anaescobarj/aco-swarm/out/convergence.png

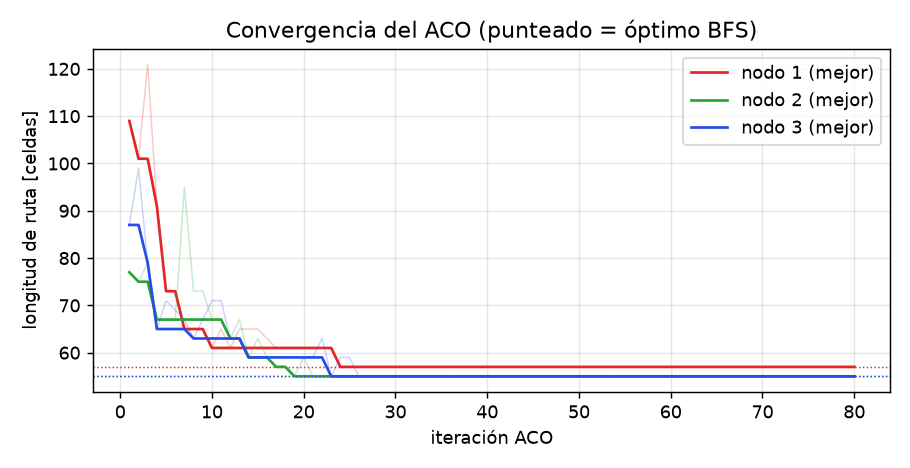
out/convergence.png
