anaescobarj/aco-swarm/robot-esp32/docs/img/app_control.png

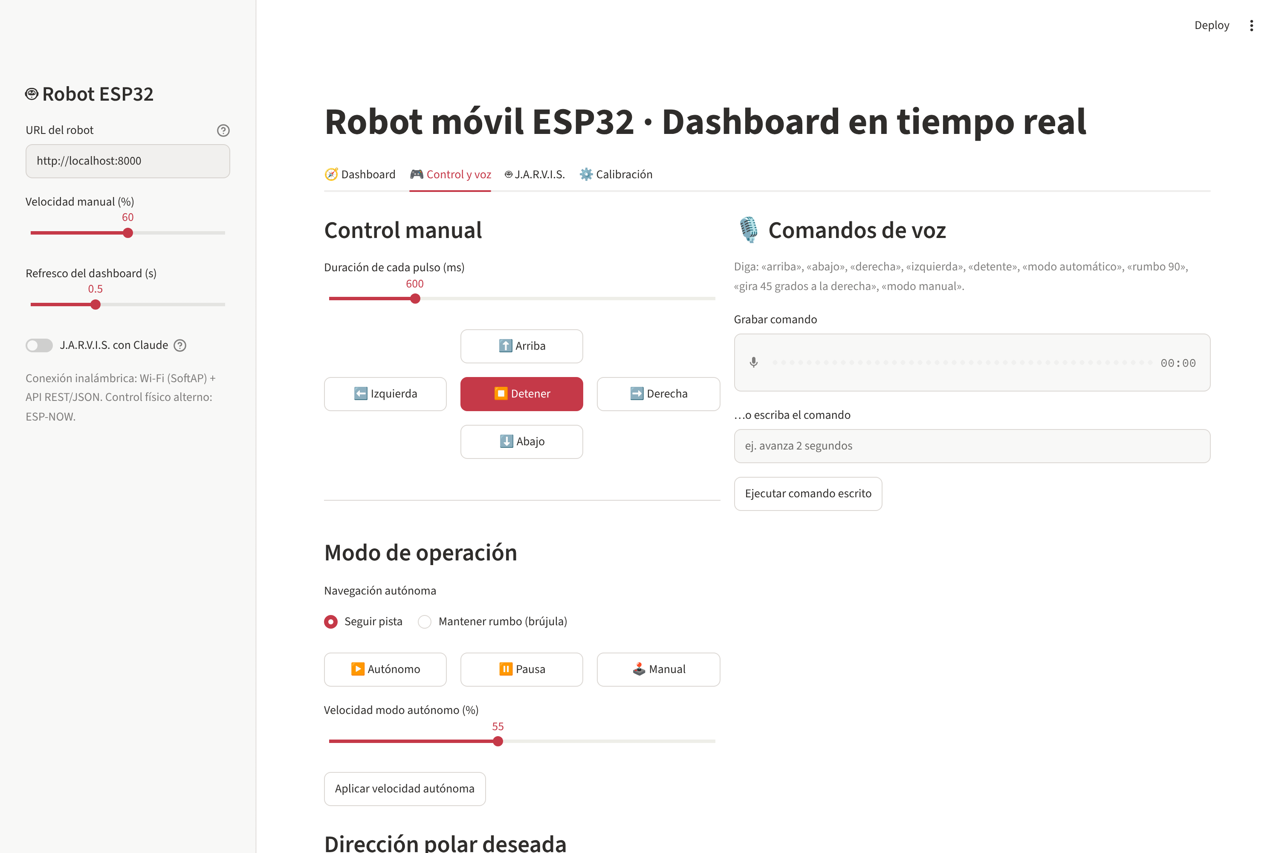
robot-esp32/docs/img/app_control.png
