anaescobarj/aco-swarm/robot-esp32/docs/img/bloque_app.png

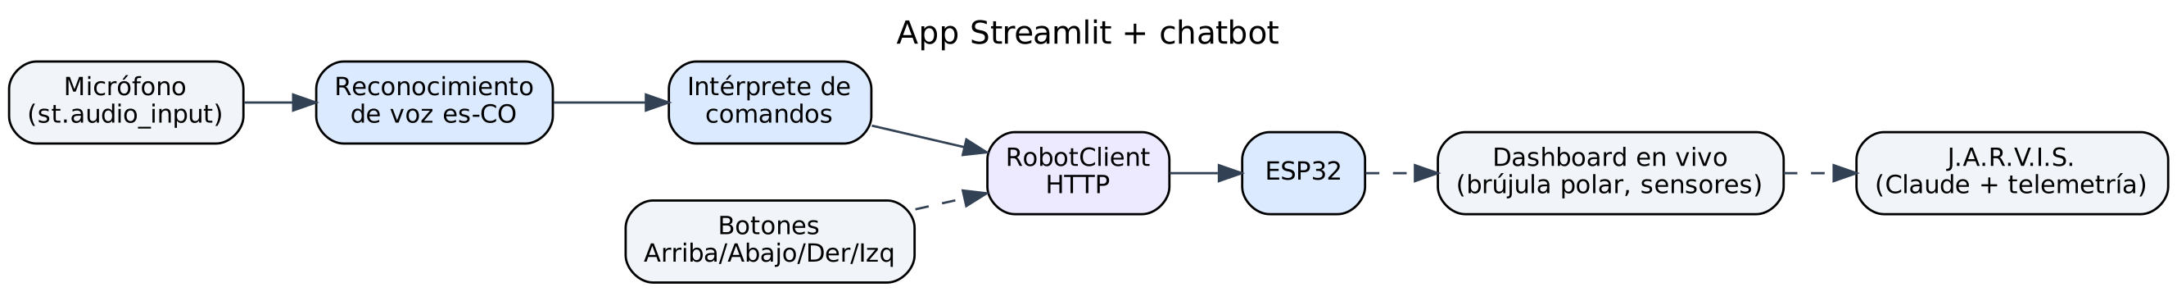
robot-esp32/docs/img/bloque_app.png
