anaescobarj/aco-swarm/robot-esp32/docs/img/bloque_brujula.png

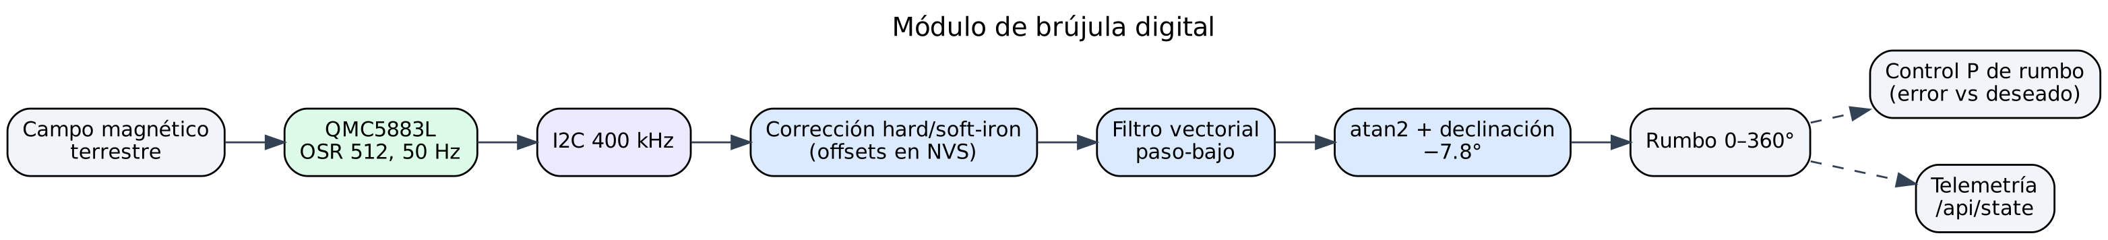
robot-esp32/docs/img/bloque_brujula.png
