anaescobarj/aco-swarm/robot-esp32/docs/img/bloque_color.png

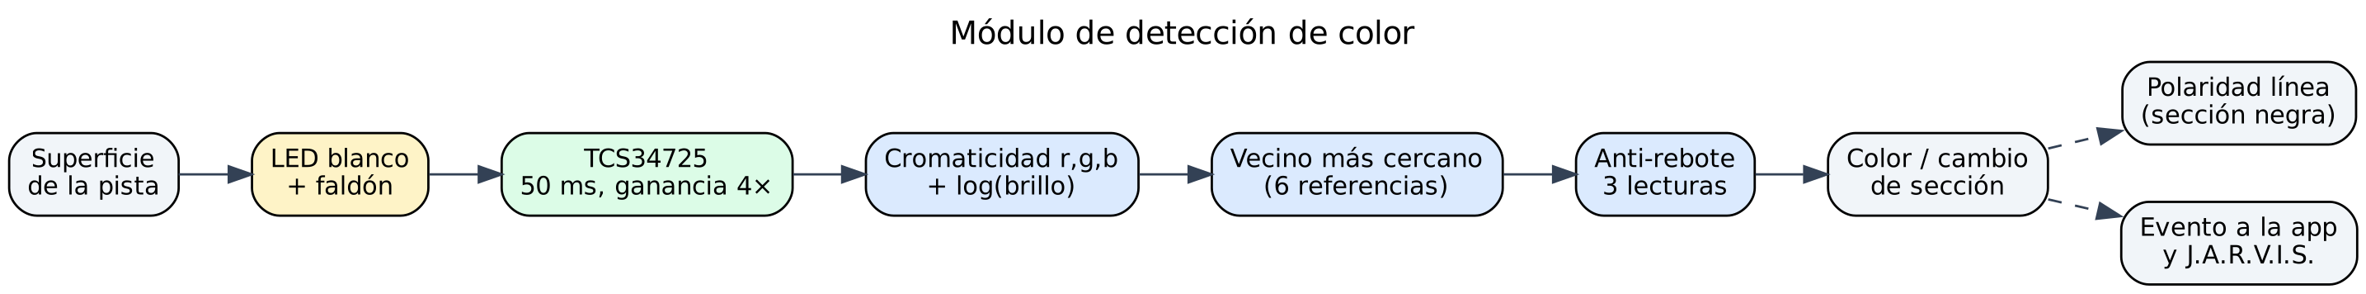
robot-esp32/docs/img/bloque_color.png
