anaescobarj/aco-swarm/robot-esp32/docs/img/bloque_comunicaciones.png

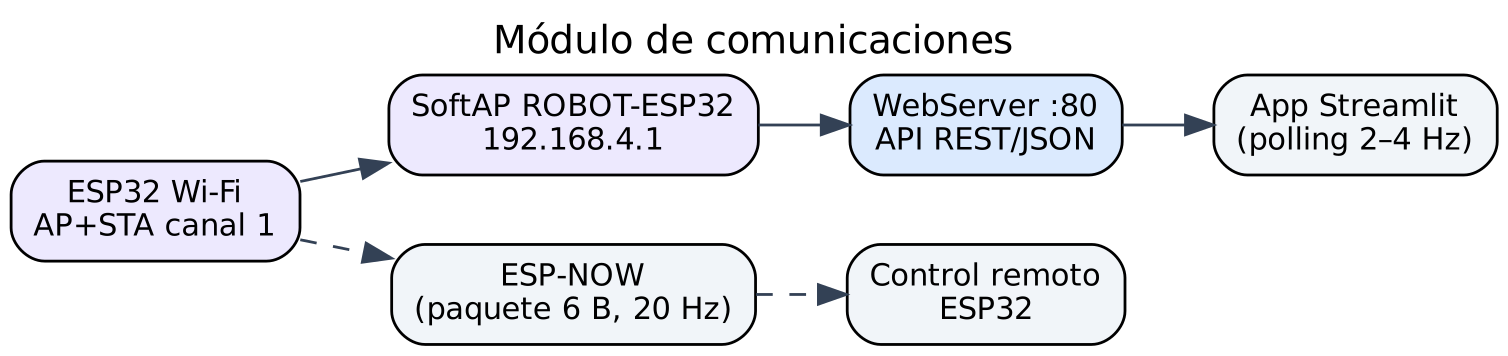
robot-esp32/docs/img/bloque_comunicaciones.png
