anaescobarj/aco-swarm/robot-esp32/docs/img/bloque_locomocion.png

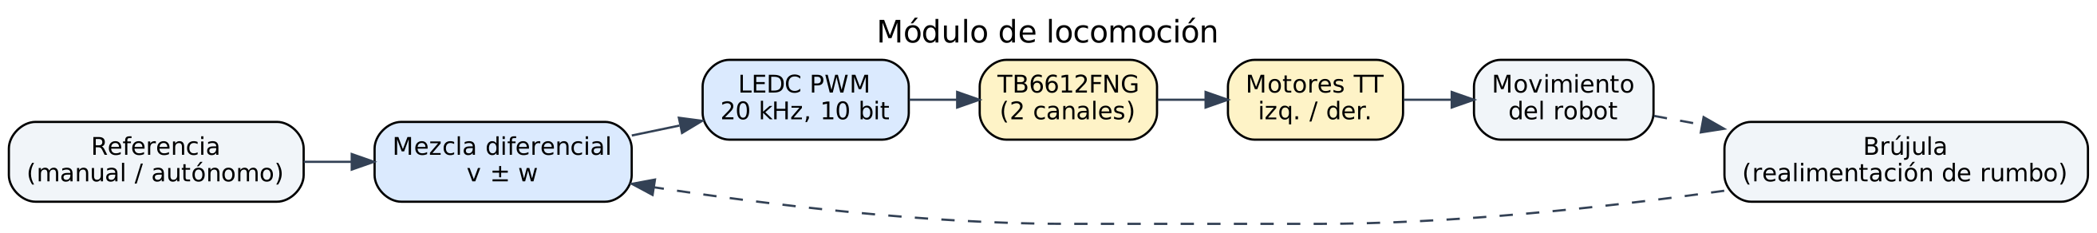
robot-esp32/docs/img/bloque_locomocion.png
