anaescobarj/aco-swarm/robot-esp32/docs/img/esquematico.png

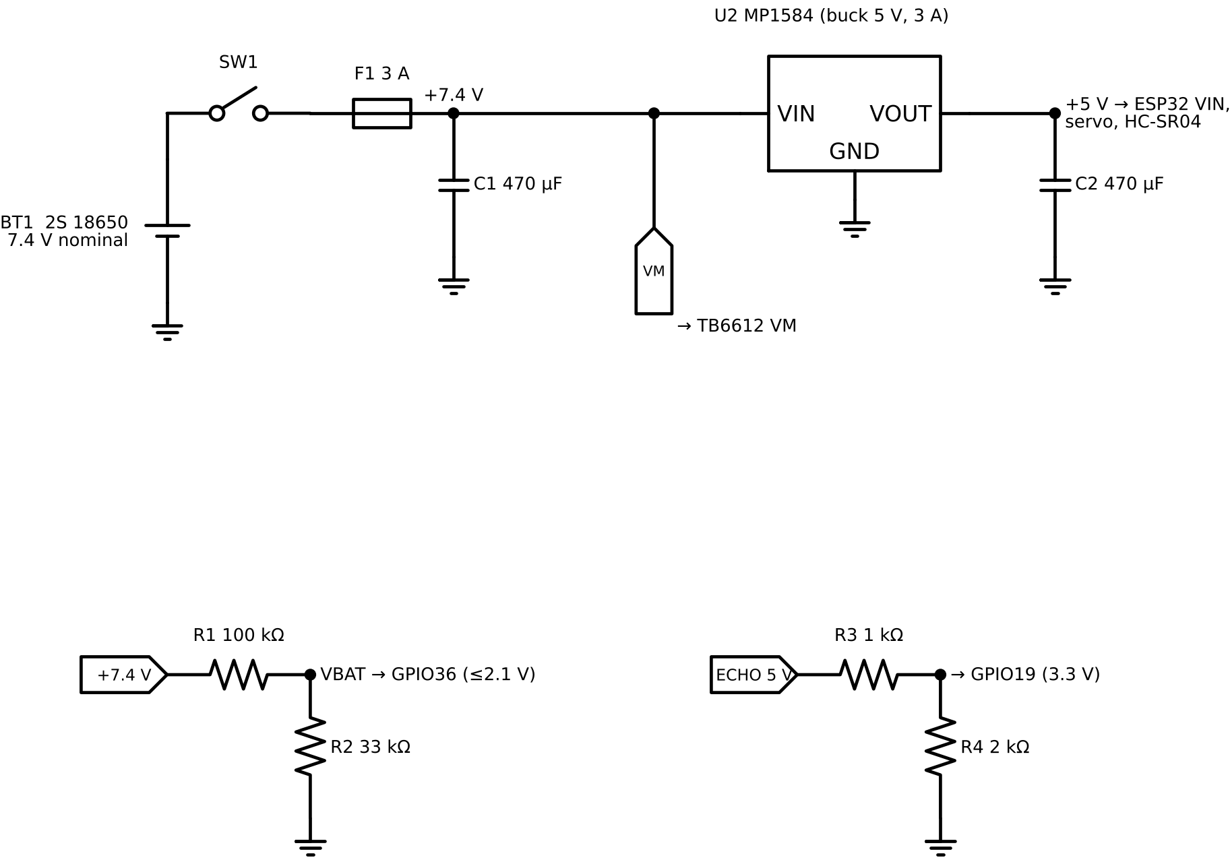
robot-esp32/docs/img/esquematico.png
