anaescobarj/aco-swarm/robot-esp32/docs/img/esquematico_esp32.png

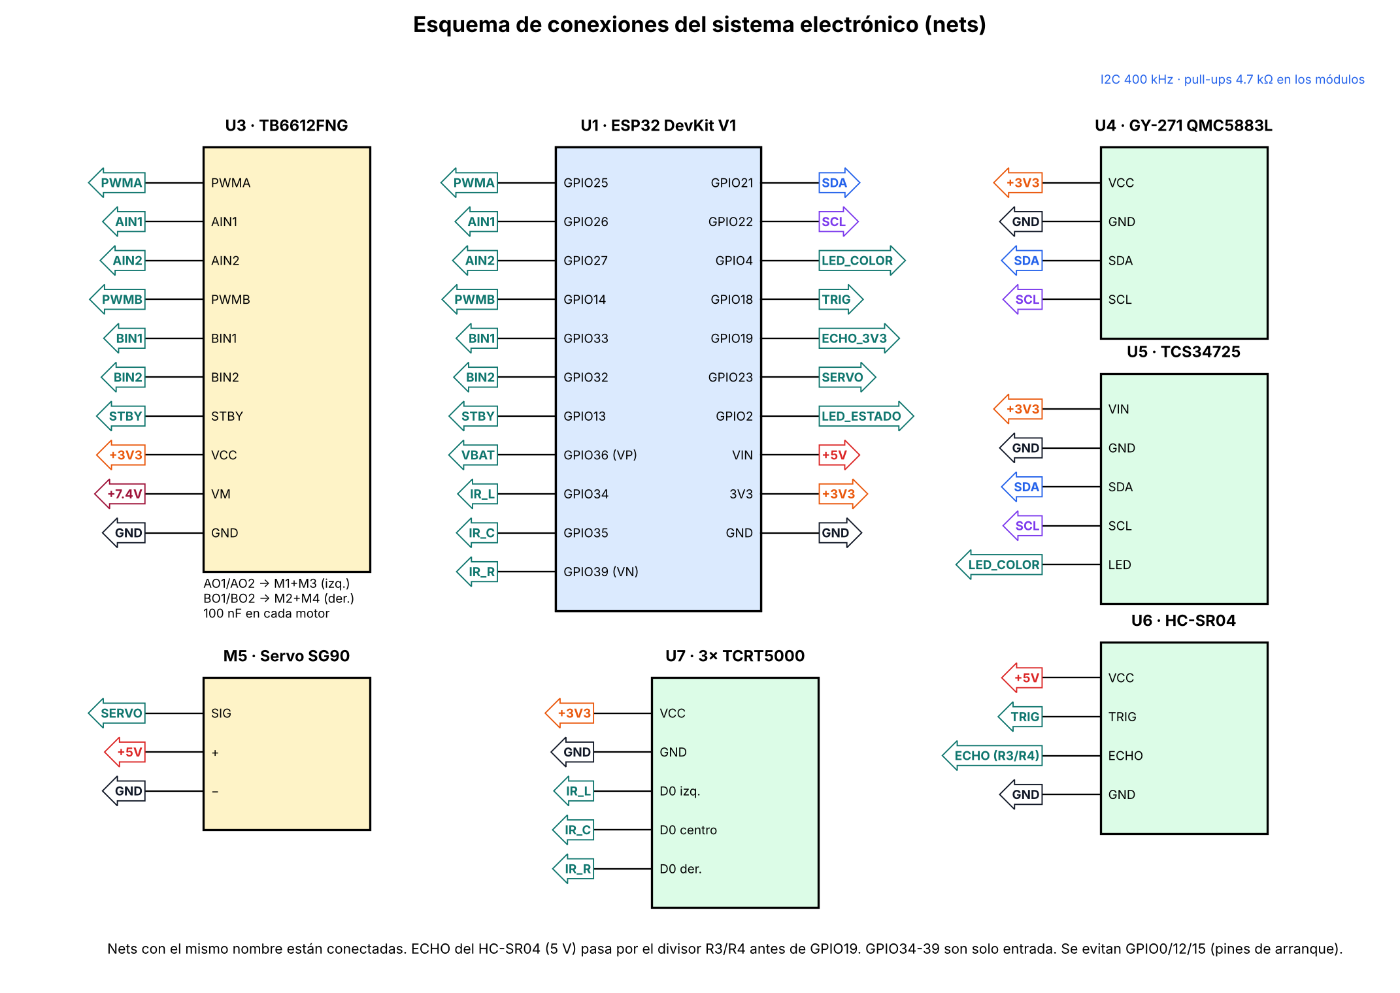
robot-esp32/docs/img/esquematico_esp32.png
