anaescobarj/aco-swarm/robot-esp32/docs/img/plano_lateral.png

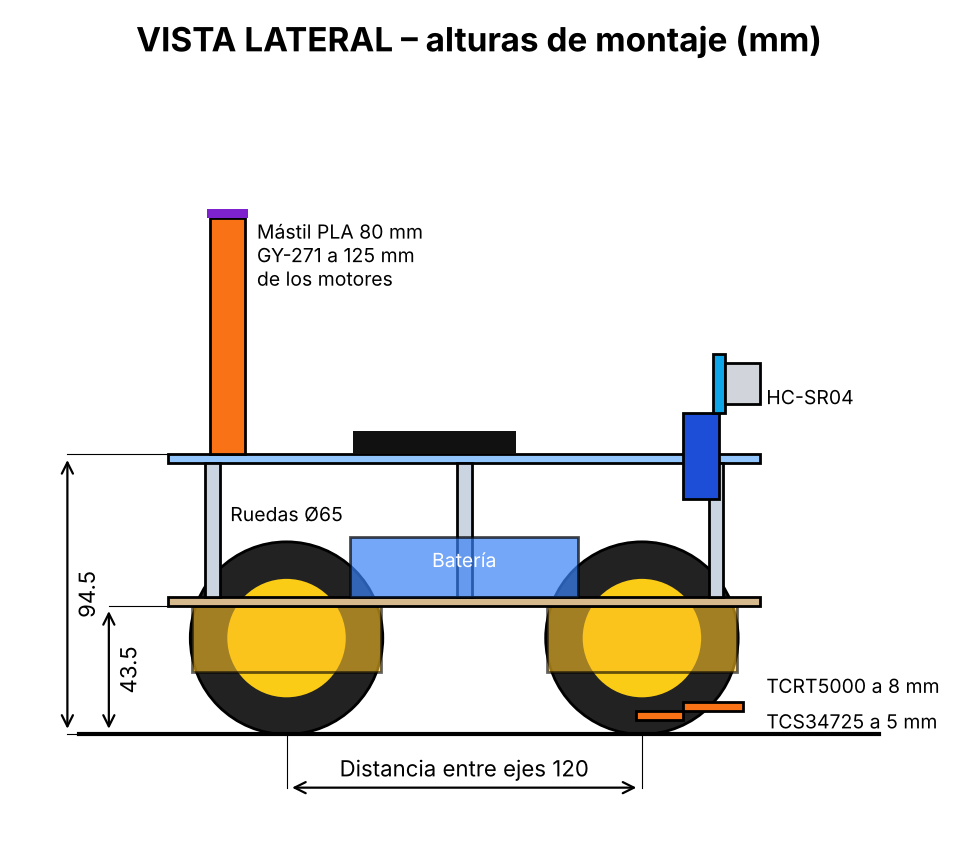
robot-esp32/docs/img/plano_lateral.png
