anaescobarj/aco-swarm/robot-esp32/docs/img/plano_placa_superior.png

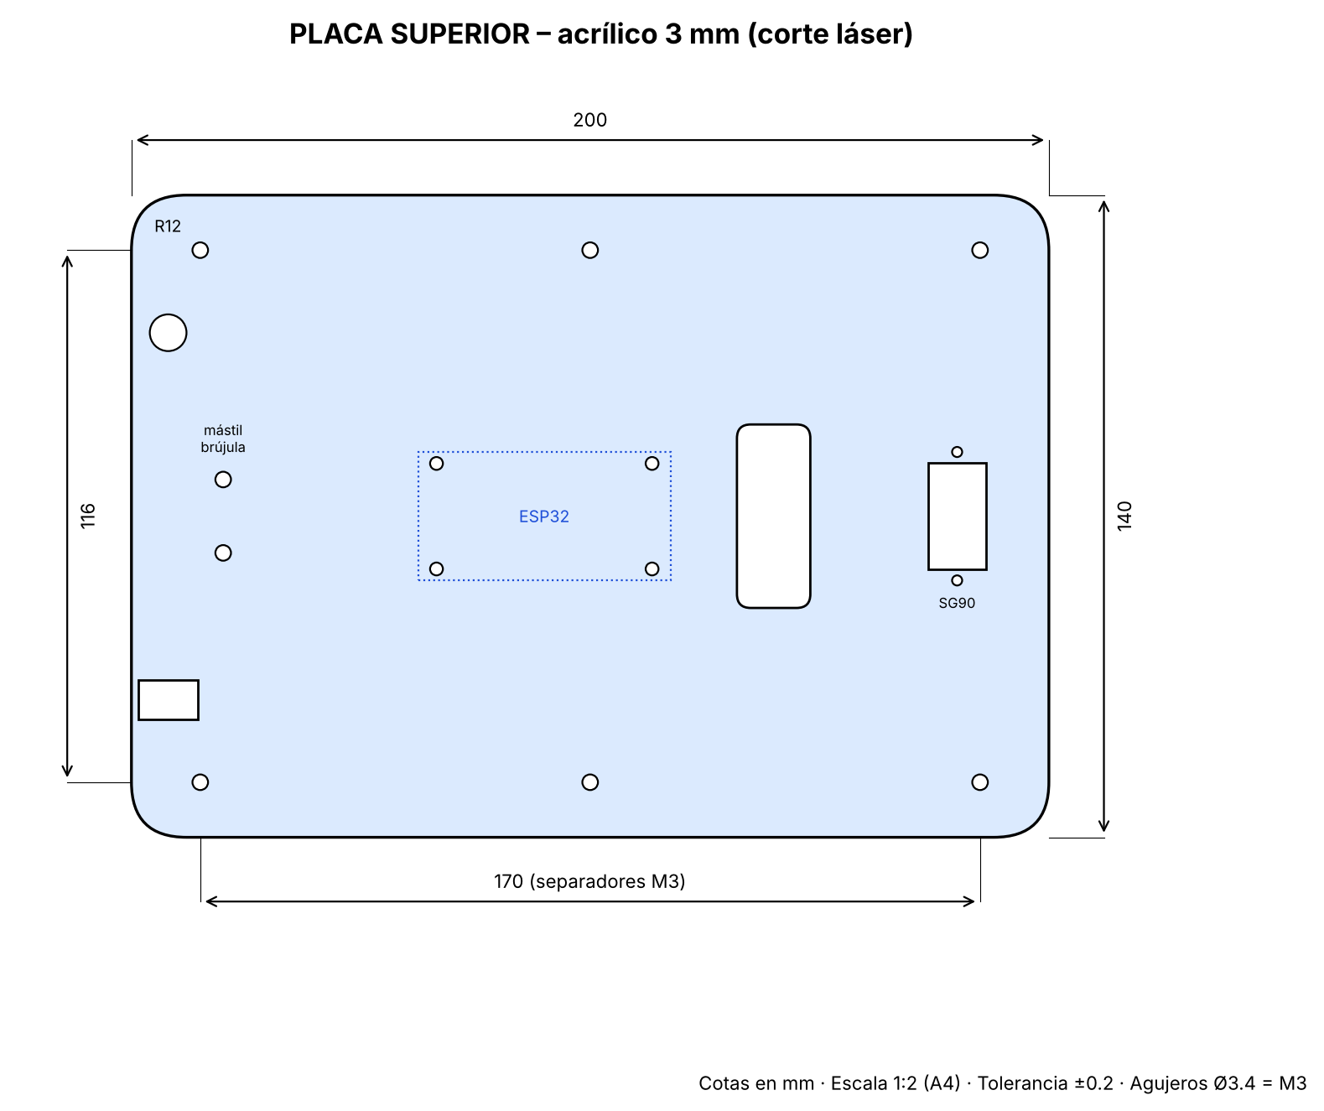
robot-esp32/docs/img/plano_placa_superior.png
