anaescobarj/aco-swarm/robot-esp32/hardware/cad/render_iso.png

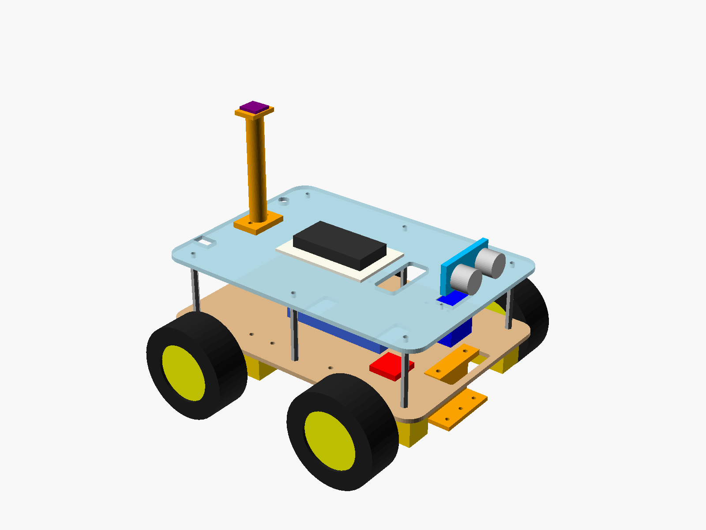
robot-esp32/hardware/cad/render_iso.png
