anaescobarj/aco-swarm/robot-esp32/hardware/cad/render_lado.png

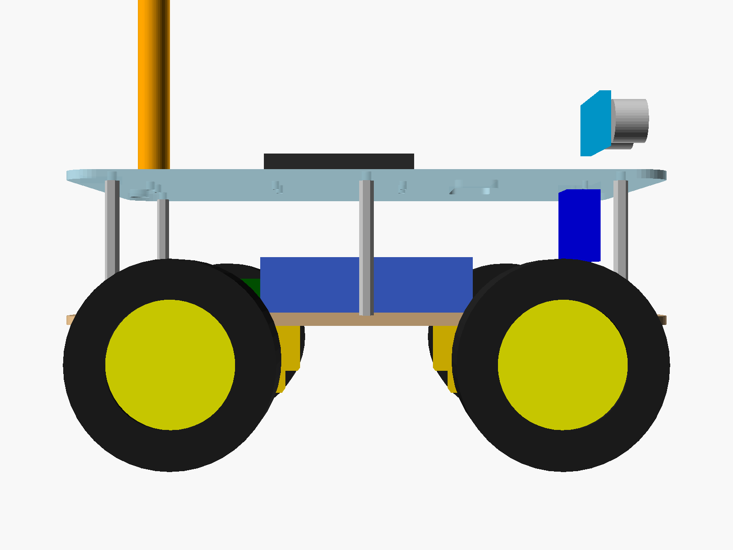
robot-esp32/hardware/cad/render_lado.png
