anaescobarj/aco-swarm/robot-esp32/hardware/cad/soporte_sensores.stl

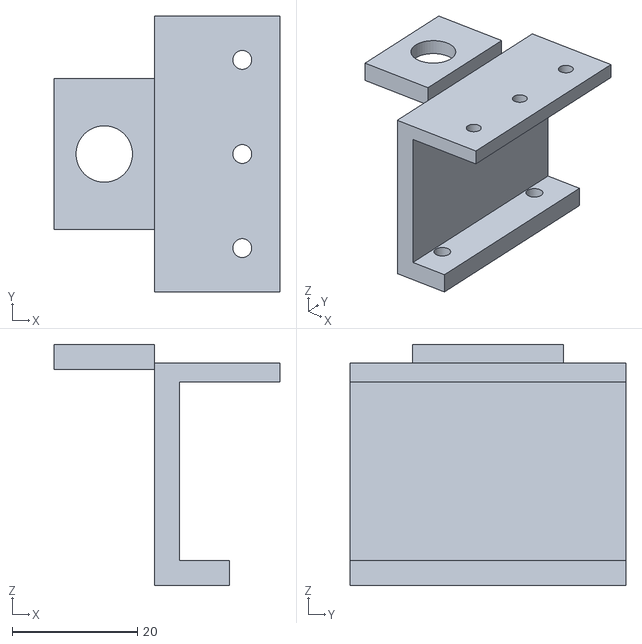
[picture p31: CAD file, 2026-11-06]
robot-esp32/hardware/cad/soporte_sensores.stl
36.0 x 44.0 x 38.5
