anaescobarj/aco-swarm/robot-esp32/hardware/cad/soporte_sonar.stl

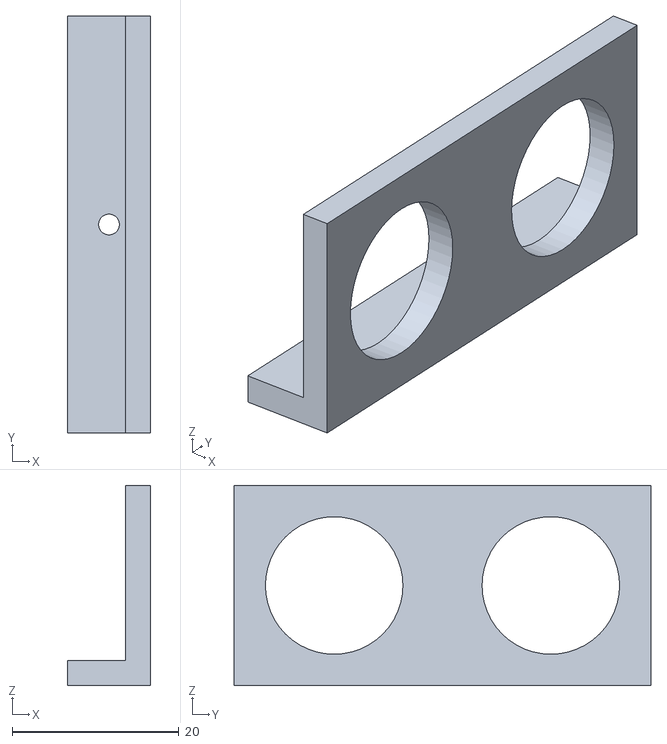
[picture p33: CAD file, 2026-11-06]
robot-esp32/hardware/cad/soporte_sonar.stl
10.0 x 50.0 x 24.0
