anaescobarj/aco-swarm/robot-esp32/hardware/cad/mastil.stl

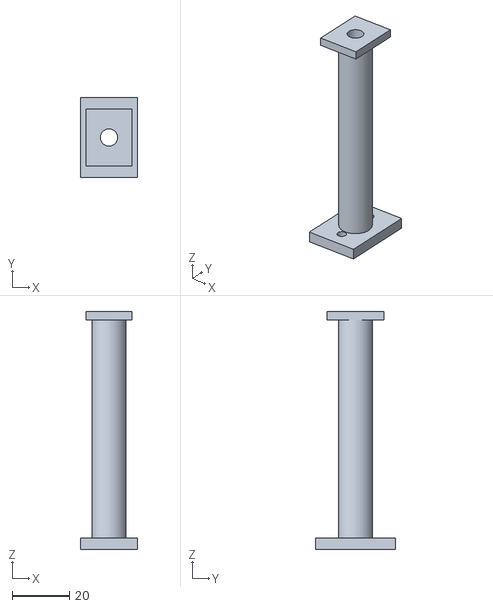
[picture p34: CAD file, 2026-11-06]
robot-esp32/hardware/cad/mastil.stl
20.0 x 28.0 x 83.0
