anaescobarj/aco-swarm/robot-esp32/hardware/cad/placa_base.dxf

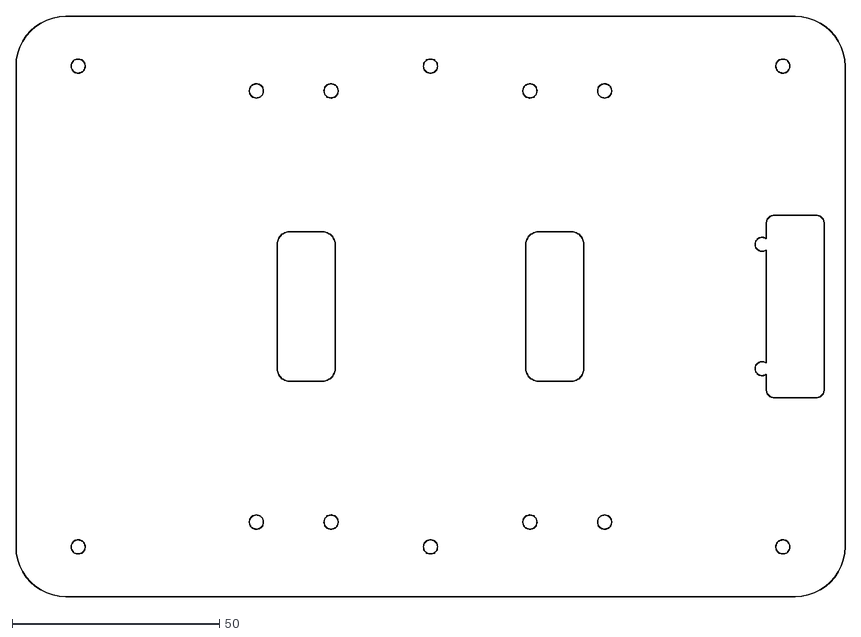
[picture p35: CAD file, 2026-11-06]
robot-esp32/hardware/cad/placa_base.dxf
200.0 x 140.0
