anaescobarj/aco-swarm/(commit log)

2026-10-14 Proyecto ACO enjambre Docker
    [convergence.csv]
2026-11-06 Agregar Primer Entregable del Proyecto Final: robot móvil ESP32
    - Firmware modular del robot (TB6612FNG, brújula QMC5883L, color TCS34725,
    HC-SR04 + servo, 3x TCRT5000) con máquina de estados autónoma, API REST
    sobre Wi-Fi SoftAP y recepción ESP-NOW; firmware del control remoto.
    - App Streamlit: dashboard con dirección polar actual/deseada en tiempo
    real, control manual por botones y voz, calibración y chatbot J.A.R.V.I.S.
    - Gemelo digital con la misma API del firmware para las tres pistas de la
    meta final, más 22 pruebas automáticas.
    - CAD paramétrico (OpenSCAD) con DXF/STL, planos acotados, esquemas
    eléctricos, diagramas de bloques e informe PDF del entregable.
    Co-Aut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
    [chasis.scad, mastil.stl, placa_base.dxf, placa_superior.dxf, soporte_sensores.stl, soporte_sonar.stl]
2026-11-09 Agregar termistor NTC para protección térmica de las baterías
    - Firmware: NTC 10k B3950 en GPIO33 (ADC1; BIN1 pasa a GPIO16), ecuación
    Beta con filtro, aviso a 45 °C, corte a 55 °C con histéresis de 5 °C
    (detiene motores y bloquea el modo autónomo). Telemetría temp_c,
    temp_ok y temp_alarm.
    - Simulador: modelo térmico de primer orden y endpoint /api/sim/temp.
    - App y J.A.R.V.I.S.: métrica y alarma de temperatura.
    - Pruebas de la protección térmica (24 en total).
    Claude-Session: https://claude.ai/code/session_01LGTc82EPd6Fg9fZsEs5sNu
